medibrick2025/ECG_BIOZ_Brick/README.md

# Bio Impedance and Bio Potential

<a href="./assets/pictures/ECG_BIOZ_Front_Closed_without_Plugins.jpg" target="_blank" style="float: right; margin-left: 20px;">
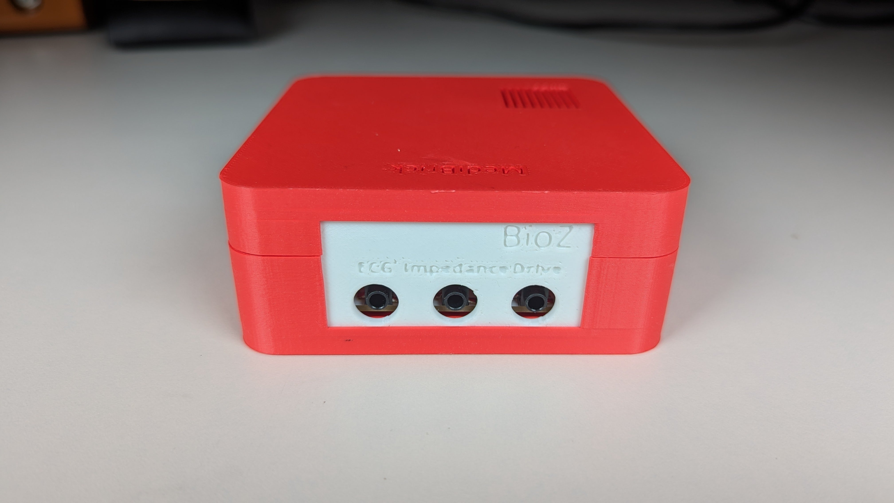
[picture p1: assets/pictures/ECG_BIOZ_Front_Closed_without_Plugins.jpg]
  
</a>

In the BIOZ and ECG MediBrick we use the MAXIM [MAX30001G](datasheets/max30001g.pdf) analog front end (AFE). It's a modern IC with a "waver level packaging" foot print which makes is difficult to solder and requires precise PCB manufacturing.

The MAX30001G can measure:

- Biopotential
  - ECG (waveform)
  - R-R Time (heart rate and heart rate variability)
- Bioimpedance
  - Resp (respiration rate)
  - GSR (galvanic skin response, stress level)
  - EDA (electro dermal activity)

In [MAX3001G](./docs/chips/MAX30001/MAX30001G.md) we summary capabilities from the datasheet.

For general consideration of bio impedance design and safety: [Analog Devices: Bio-Impedance Circuit Design for Body Worn Systems"](https://www.analog.com/en/resources/analog-dialogue/articles/bioimpedance-circuit-design-challenges.html)

## Costs &#36;

| Item | Quantity at Purchase | Costs  | Source | Cost per Brick
|--- | ---  | --- | --- | ---
| Microcontroller |  1 | $17.5  | [Adafruit](https://www.adafruit.com/product/5477) | $17.5
| Display |  5 | $13 | [Amazon](https://a.co/d/1QH0Ab9) | $3
| Button | 25 | $9 | [Amazon](https://a.co/d/8KAuTwC) | $0.5 
| Battery |  1 | $10 | [Adafruit](https://www.adafruit.com/product/258) | $10
| PCB |  5 | $145.80 | PCBWay | $29
| Parts and Assembly |  5 | $186.42 | PCBWay | $38
| Assorted Wires |8m | $15 | [Amazon](https://a.co/d/58djefc) | $1
| Assorted Screws and Nuts |100 |  $7 | Amazon | $0.05
| Assorted 3D printed parts | | | | $3
| ECG 3.5mm cables | 1  | $5.50 | [Sparkfun](https://www.sparkfun.com/products/12970) | $5.50
| Electrodes (consumable) | 100 | $25 | [Amazon](https://a.co/d/85M2rC2) | $ 1
| | | | |
| **Total** | | | | **$110**

Electronic components are $20 per board. Because of WLP foot print of MAX30001G the PCB is 3 times as expensive as the other PCBs.

## Test Software &#128187;
Test software is located in the Arduino folder.

| Folder | Description | 
|--- |---|
| MAX30001G Driver | under development |
| Test programs | not available yet |

## Microcontroller Software : &#9000;
Not available yet.

## Electronics Design &#128268;

<a href="./hardware/schemaric/Impedance_Potential_schematic.pdf" target="_blank">
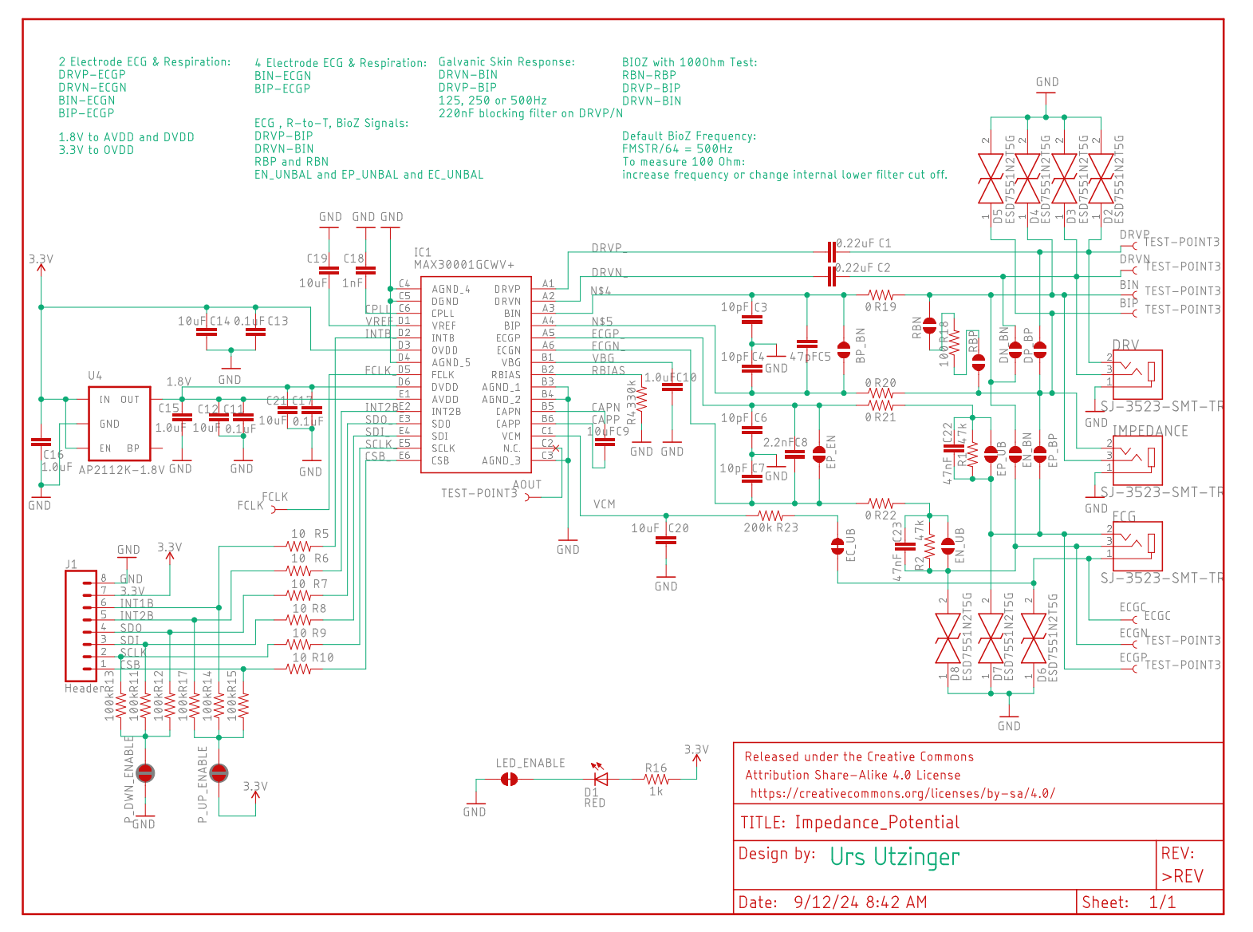
[picture p2: hardware/schemaric/Impedance_Potential_schematic.png]
  
</a>

<a href="./hardware/layout/Impedance_Potential_board.pdf" target="_blank">
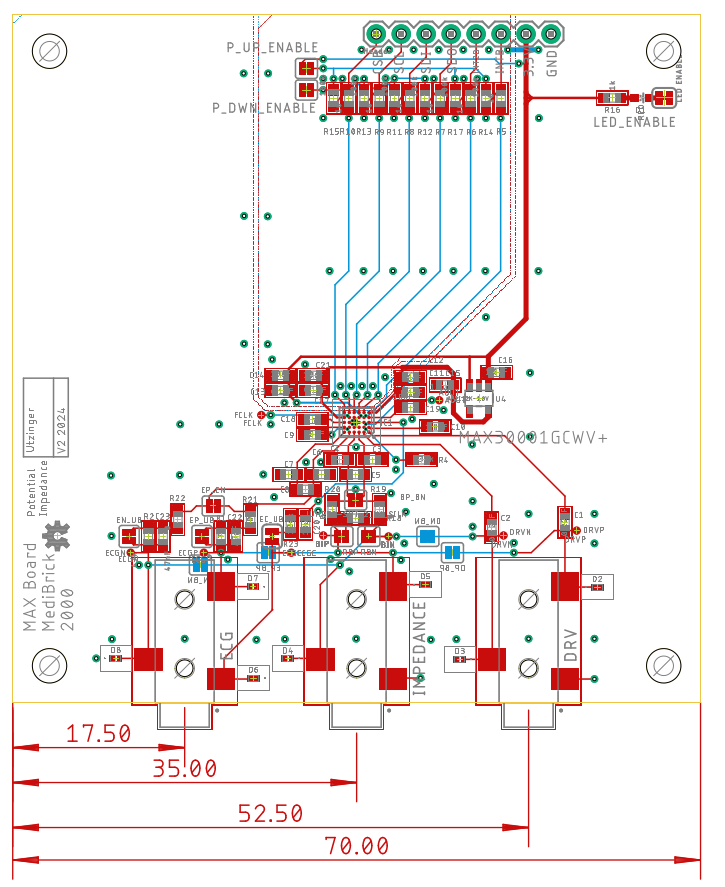
[picture p3: hardware/layout/Impedance_Potential_board.png]
  
</a>

The following files are needed for PCB manufacturing and assembly.

- [Bill of Materials](./hardware/bom/Impedance_Potential_BOM.xlsx)
- [Manufacturing Files](./hardware/manufacturing/Impedance_Potential_2024-09-12.zip)
- [Pick and Place](./hardware/pick_and_place/Impedance_Potential_PnP.xlsx)

The Bill of Materials is formatted so that its compatible with PCBWay submissions.

## 3D Printed Parts &#9881;
These are the links to the OnShape Design files, which you can edit and modify if you have an OnShape account (OnShape has free academic accounts).

- Medi Brick
  - [Brick Top](https://cad.onshape.com/documents/be6b7e5f847d89f3ec5eb9d5/w/761fee9865ca7ef709028476/e/ff897b4f359cec83b782ff14)
  - [Brick Bottom](https://cad.onshape.com/documents/92ad78475e8f0b17ff5e260b/w/88a02abbcb12cdbd4d9de3ad/e/fb79ca58ad2b6a0298e9d1b6)
  - [Brick Assembly](https://cad.onshape.com/documents/11cbfe9c3c739b6e8ecbf3d7/w/989b564ecd7f6d069e643ac0/e/85542f706be8cc7554218e8d)
  - [Impedance Potential Plate](https://cad.onshape.com/documents/4b23bdc1fe41aa5490b46d9c/w/fd4737f6a1ca7fbcd3b1d7f7/e/89122d5ddac798ebf451ad60)

## Assembly Instructions &#128736;
[Instructions](./docs/assembly.md)

## MAX30001G Design

## Block Diagram of MAX 30001G

<a href="./assets/Blockdiagram.png" target="_blank">
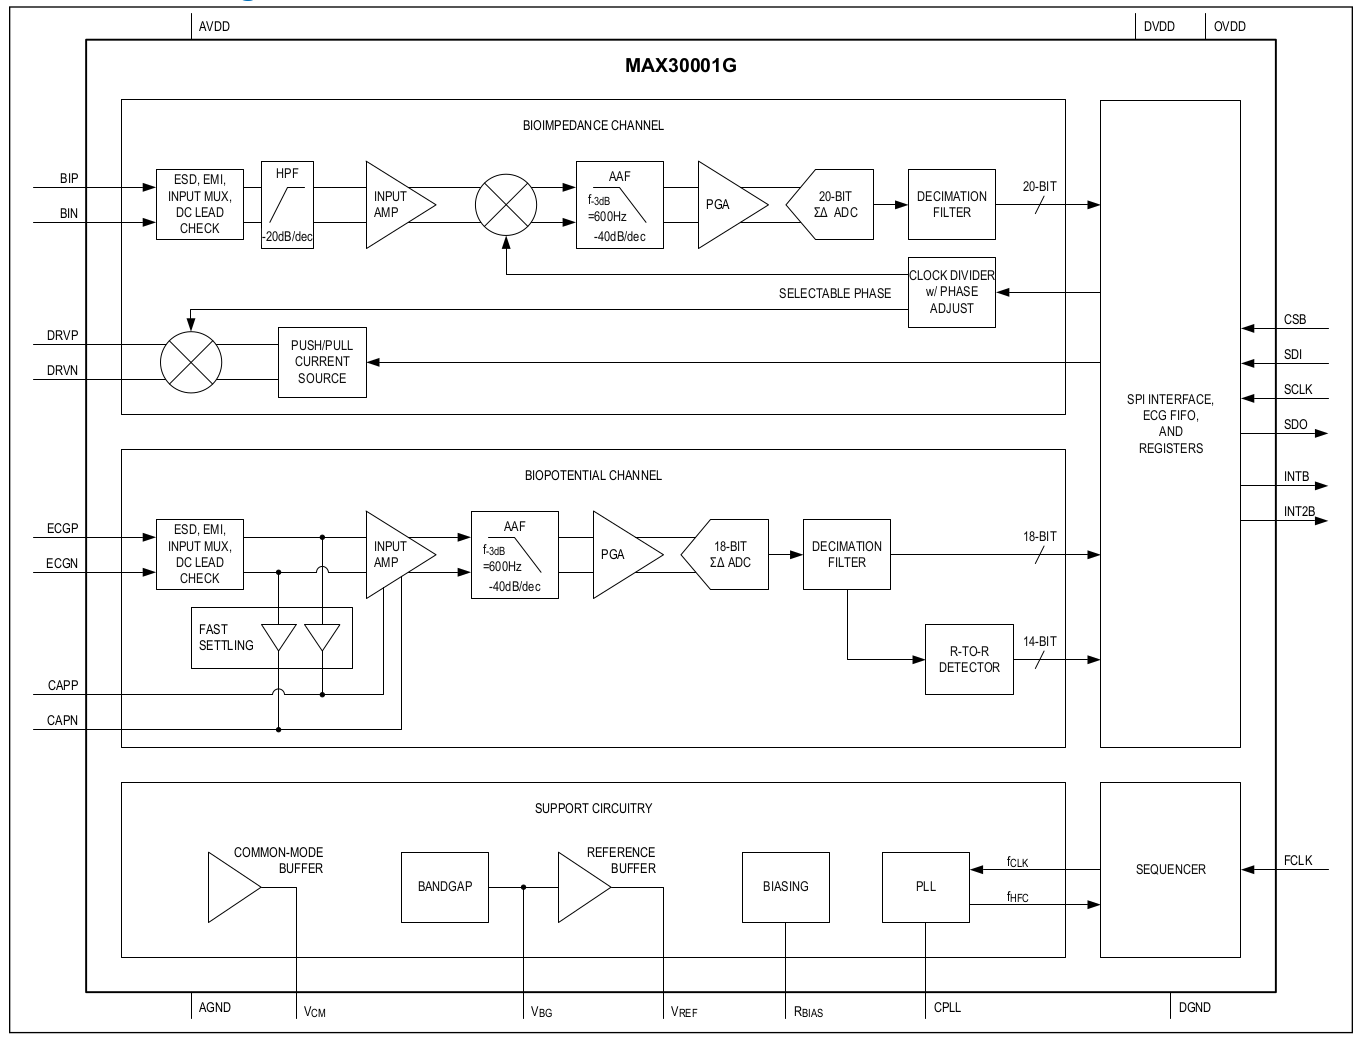
[picture p4: assets/Blockdiagram.png]
  
</a>

## External Configuration Options

<a href="./docs/images/system/Design.svg" target="_blank">
  
</a>

We have the following external connectors:
- ECG, 3,5mm audio
    - ECG_N (middle of plug) e.g. left arm
    - ECG_P (proximal side of plug) e.g. right arm
    - VCM/ECG_GND (common mode) (tip of plug) e.g. leg

- Impedance, 3.5mm audio
    - BI_N
    - BI_P
    - GND (tip of plug)

- Driver, 3.5mm audio
    - DRV_P
    - DRV_N
    - GND (tip of plug)

### Options
- We can operate the board to measure ECG or Impedance or both. 
- We can operate the board to use only two leads, four leads or six leads. 
    - 6 leads ECG on ECGP & ECGN, BIOZ on BINP & BINN and DRV on DRVP & DRVN
    - 4 leads ECG on ECGP & ECGN, BIOZ on BINP & BINN
    - 2 leads ECG, BIOZ, DRV on ECGP & ECGN
- We can configure the board to measure impedance of a calibration resistor that is soldered onto the board (100 Ohm).

### Component Values

Typical values and conditions of external components

Name      | typical value | Comment
----------|---------------|--------
C_ECG     | 2.2nF         | datasheet
C_ECG-G   | 10pF          | datasheet, 47pF protocentral
EP_EN     | open          | if closed disable ECG
R_ECG     | 0,51k,200k Ohm | 0, 200k shown in datasheet (200k when ECG conencted with BIOZ), 51k protocentral, 0 Ohm evaluation kit
R_ECG-B   | 51k           | evaluation kit
C_ECG_B   | 47nF          | evaluation kit
ECG_UNBAL | open          | if closed disable balancing
||
EP_BP     | open          | impedance and ECG is on different plug
EN_BN     | open          | impedance and ECG is on different plug
||
C_BIN     | 47pF          | datasheet
C_BIN_G   | 10pF          | datasheet
BP_BN     | open          | if closed disable BioZ
R_BIN     | 0, 200 Ohm    | 200 protocentral where ECG is connected to BIN, 0 evaluation kit
R_CAL     | 100 Ohm       | evaluation kit
RP        | open          | if closed no external impedance
RN        | open          | "
||
BP_DP     | open          | impedance and driver on different plug
BN_DN     | open          | impedance and driver on different plug
||
C_DRV     | 200nF, 47nF   | 47nF protocentral, 47nF evaluation kit
||
R_VCM     | 0 Ohm,10k,200k| 10k protocentral, evaluation kit has buffer driver circuit, 200k datasheet
R_VCM-B   | 51k, none     | none protocentral & evaluation kit
C_VCM-B   | 47nF, none    | none protocentral & evaluation kit, 47nF datasheet
VMC_UNBAL | open          | 

## Education Background

This section provides the theoretical and physiological background related to ECG and bioimpedance measurements

- [ECG Education Background](./docs/ECG_Education_Background/README.md)
