medibrick2025/ECG_BIOZ_Brick/assets/BIOZ_Channel.png

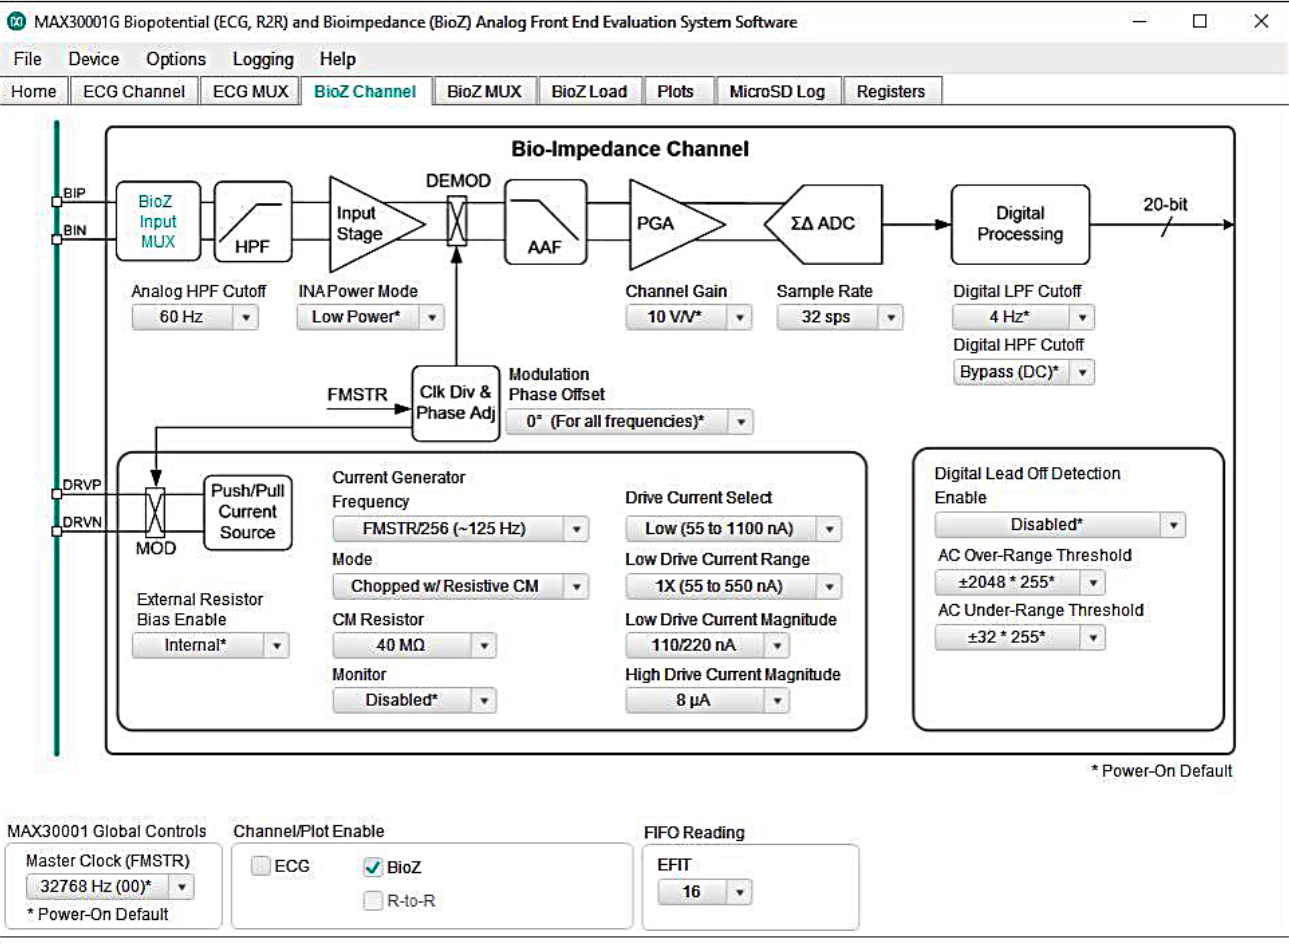
assets/BIOZ_Channel.png
