medibrick2025/ECG_BIOZ_Brick/assets/BIOZ_Load.png

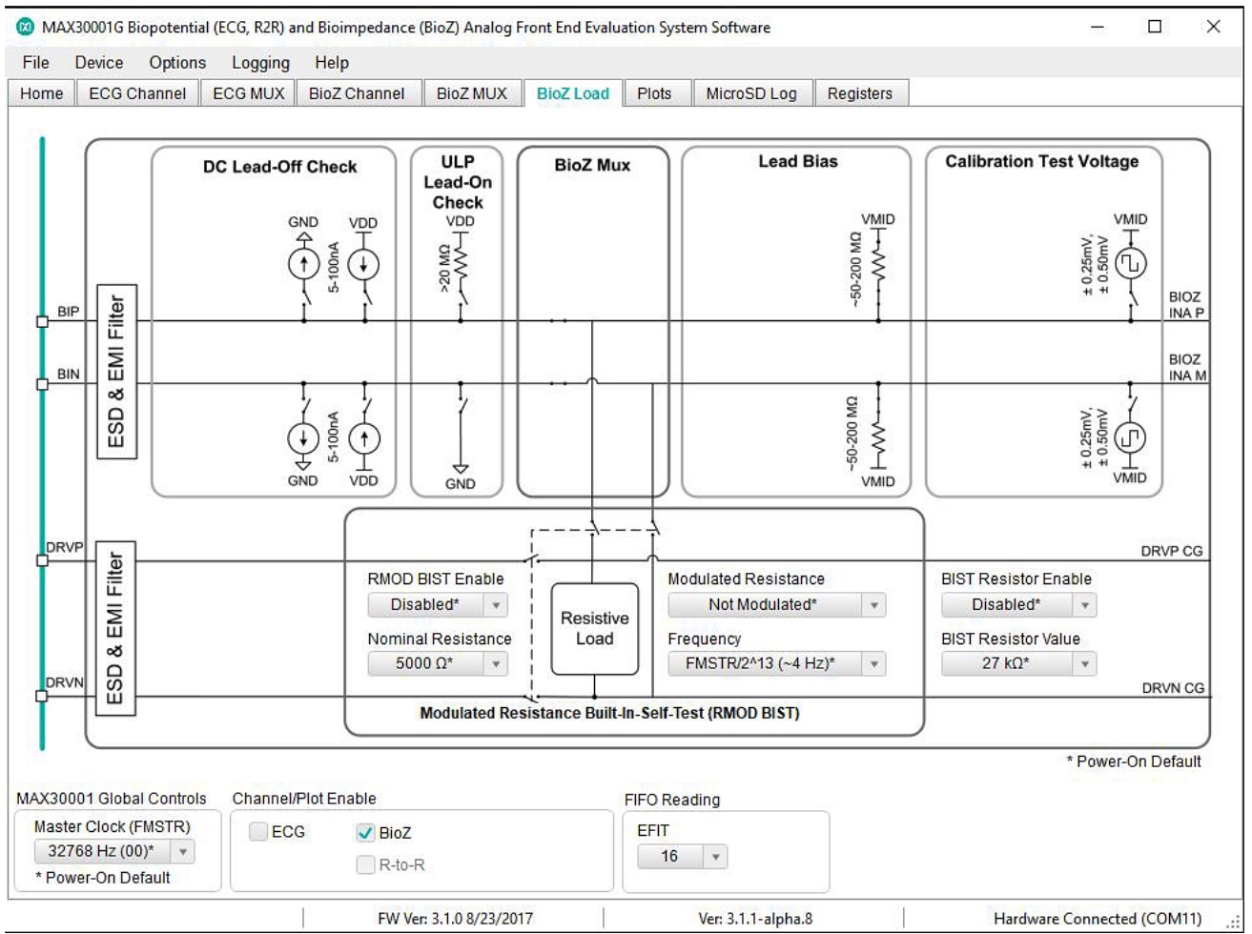
assets/BIOZ_Load.png
