medibrick2025/ECG_BIOZ_Brick/assets/BIOZ_MUX.png

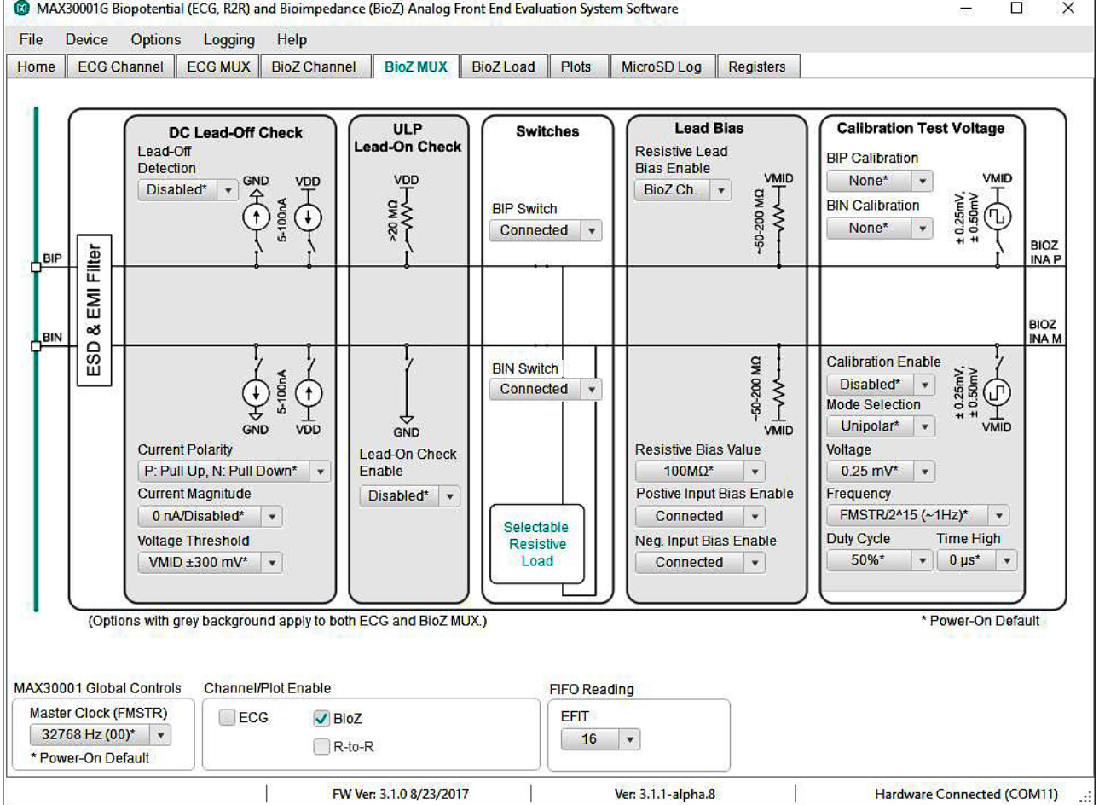
assets/BIOZ_MUX.png
