medibrick2025/ECG_BIOZ_Brick/assets/ECG_Channel.png

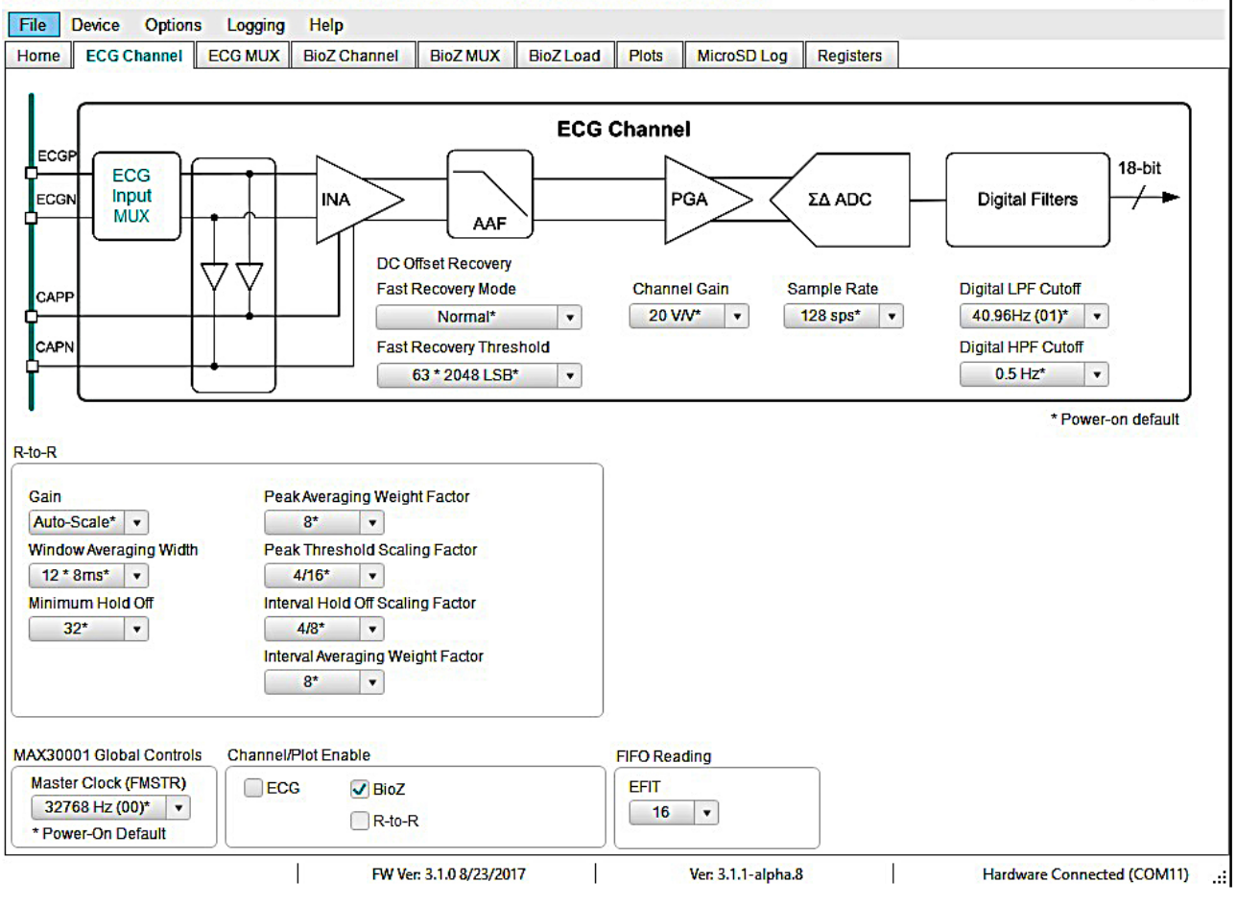
assets/ECG_Channel.png
