medibrick2025/ECG_BIOZ_Brick/assets/ECG_Mux.png

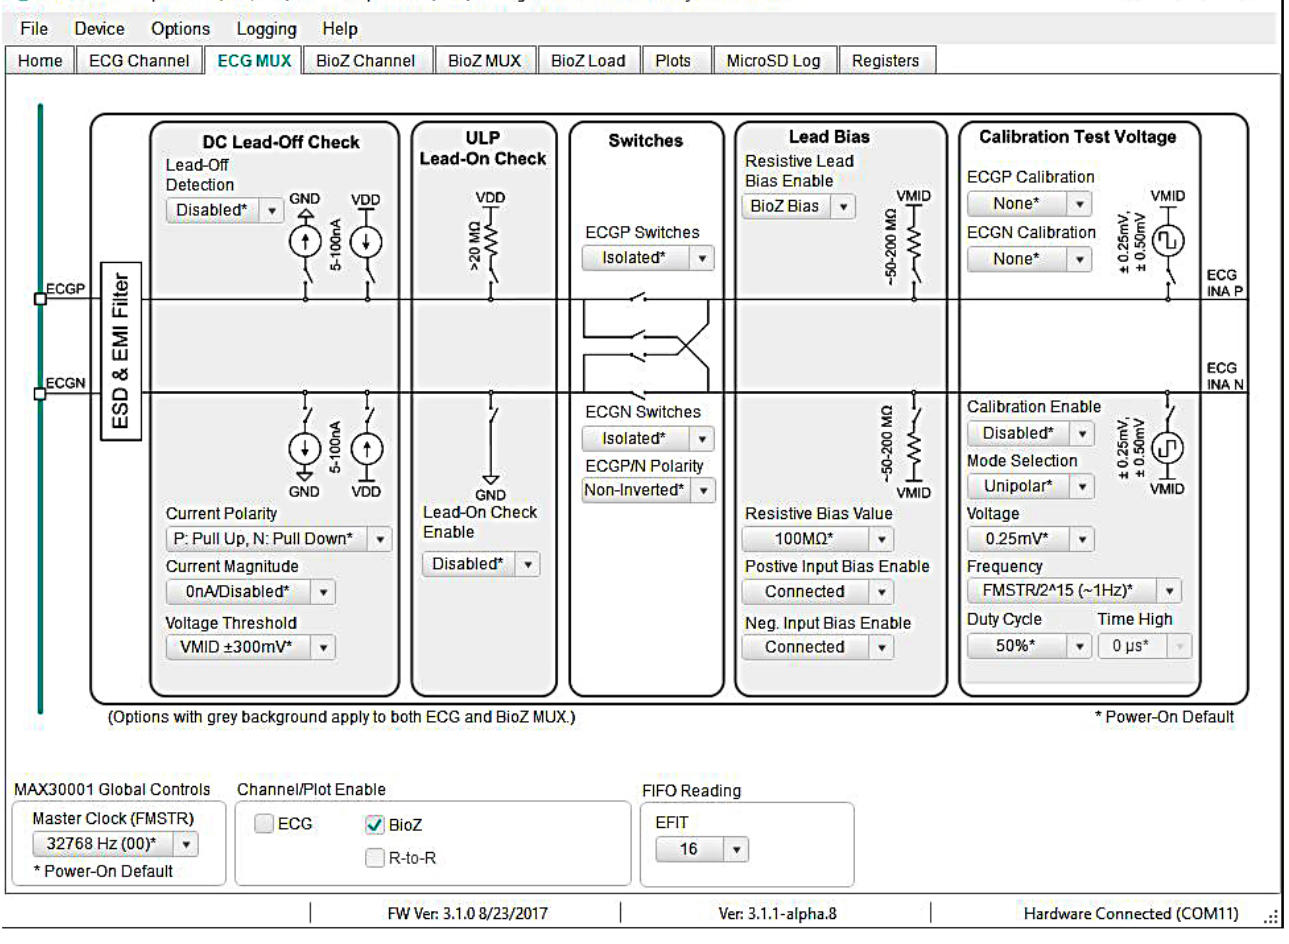
assets/ECG_Mux.png
