medibrick2025/ECG_BIOZ_Brick/assets/ECG_Plots.png

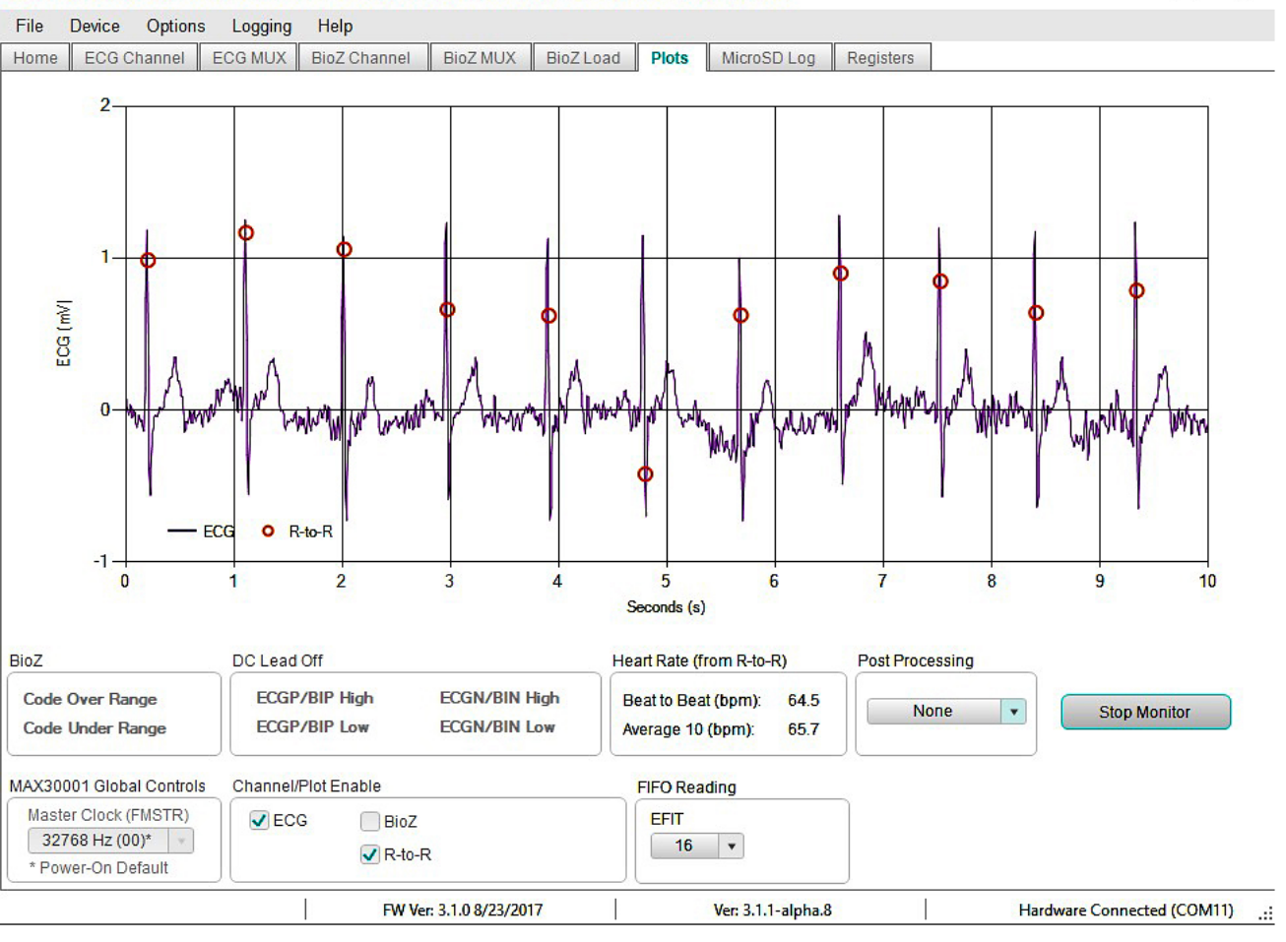
assets/ECG_Plots.png
