medibrick2025/ECG_BIOZ_Brick/pcbway/T-1Y6W735621A-5sets-Impedance_Potential_BOM_No3p5Audio(2024-04-29).xls

PCBWay Bom Quotation, Product No.:T-1Y6W735621A
Item # | *Designator | *Qty | Manufacturer | *Mfg Part # | Description / Value | Vendor Part # | *Package/Footprint | Mounting Type | *Unit Price(5 sets) | *Total | *Delivery Time | *PCBWay Note | Customer Reply
1 | C1, C2 | 2 | Samsung Electro-Mechanics | CL10B224KA8NNNC | 0.22uF Ceramic Capacitor >=25V | C21120 | 603 | SMD | $0.050 | $0.500
2 | C3, C4, C6, C7 | 4 | Samsung Electro-Mechanics | CL10C100JB8NNNC | 10pF Ceramic Capacitor >=25V | C1634 | 603 | SMD | $0.037 | $0.740
3 | C5 | 1 | Samsung Electro-Mechanics | CL10C470JB8NNNC | 47pF Ceramic Capacitor >=25V | C1671 | 603 | SMD | $0.050 | $0.250
4 | C8 | 1 | Samsung Electro-Mechanics | CL10B222KB8NNNC | 2.2nF Ceramic Capacitor >=25V | C16033 | 603 | SMD | $0.050 | $0.250
5 | C9, C12, C14, C19, C20, C21 | 6 | Samsung Electro-Mechanics | CL10A106MA8NRNC | 10uF Ceramic Capacitor >=25V | C96446 | 603 | SMD | $0.034 | $1.020
6 | C10, C15, C16 | 3 | Samsung Electro-Mechanics | CL10A105KB8NNNC | 1.0uF Ceramic | C15849 | 603 | SMD | $0.040 | $0.600
7 | C11, C13, C17 | 3 | Samsung Electro-Mechanics | CL10B104KB8NNNC | 0.1uF Ceramic Capacitor >=25V | C1591 | 603 | SMD | $0.022 | $0.330
8 | C18 | 1 | Samsung Electro-Mechanics | CL10B102KB8NNNC | 1nF Ceramic Capacitor >= 25V | C1588 | 603 | SMD | $0.050 | $0.250
9 | C22, C23, C24 | 3 | Samsung Electro-Mechanics | CL10B473KB8NNNC | 47nF Ceramic Capacitor >=25V | C1622 | 603 | SMD | $0.039 | $0.585
10 | R1, R2, R3 | 3 | YAGEO | RC0603FR-0751KL | 51k 100mW Resistor | C107231 | 603 | SMD | $0.011 | $0.165
11 | R4 | 1 | YAGEO | RT0603BRE07324KL | 324k 100mW Resistor | C861836 | 603 | SMD | $0.147 | $0.735
12 | R5, R6, R7, R8, R9, R10 | 6 | YAGEO | RC0603JR-0710RL | 10 100mW Resistor | C109317 | 603 | SMD | $0.009 | $0.270
13 | R11, R12, R13, R14, R15, R17 | 6 | YAGEO | RC0603FR-07100KL | 100k 100mW Resistor | C14675 | 603 | SMD | $0.004 | $0.120
14 | R16 | 1 | YAGEO | RC0603FR-071KL | 1k 100mW Resistor | C22548 | 603 | SMD | $0.026 | $0.130
15 | R18 | 1 | YAGEO | RC0603JR-07100RL | 100 100mW Resistor | C110091 | 603 | SMD | $0.029 | $0.145
16 | R19, R20, R21, R22, R23 | 5 | YAGEO | RC0603JR-070RL | 0 100mW Resistor | C95177 | 603 | SMD | $0.005 | $0.125
17 | D2, D3, D4, D5, D6, D7, D8 | 7 | onsemi | ESD7551N2T5G | ESD7551N2T5G, Protection Diode | C5123457『 』https://www.mouser.com/ProductDetail/onsemi/ESD7551N2T5G?qs=5aG0NVq1C4x8NutXGbtG6w%3D%3D | ESD7551N2T5G | SMD | $0.308 | $10.780
18 | D1 | 1 | XINGLIGHT | XL-1608UBC-04 | Blue LED | C965807 | 603 | SMD | $0.095 | $0.475
19 | IC1 | 1 | Analog Devices/Maxim | MAX30001GCWV+ | MAX30001GCWV+ | https://www.mouser.com/ProductDetail/Analog-Devices-Maxim-Integrated/MAX30001GCWV%2b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 | BGA30C50P6X5_293X274X69 | SMD | $15.776 | $78.880 | 7-10 Workdays | Only 200pcs total in stock, please confirm ASAP.
20 | U4 | 1 | Diodes Incorporated | AP2112K-1.8TRG1 | AP2112K-1.8V V_REG_LDO SMD | C176944『 』https://www.mouser.com/ProductDetail/Diodes-Incorporated/AP2112K-1.8TRG1?qs=x6A8l6qLYDBx1xhw8AX2cw%3D%3D | SOT-25 | SMD | $0.413 | $2.065
 |  |  |  |  |  |  |  |  | Component Cost | $98.41
