medibrick2025/ECG_BIOZ_Brick/hardware/layout/Impedance_Potential.brd

## EAGLE design hardware/layout/Impedance_Potential.brd (2025-12-08)

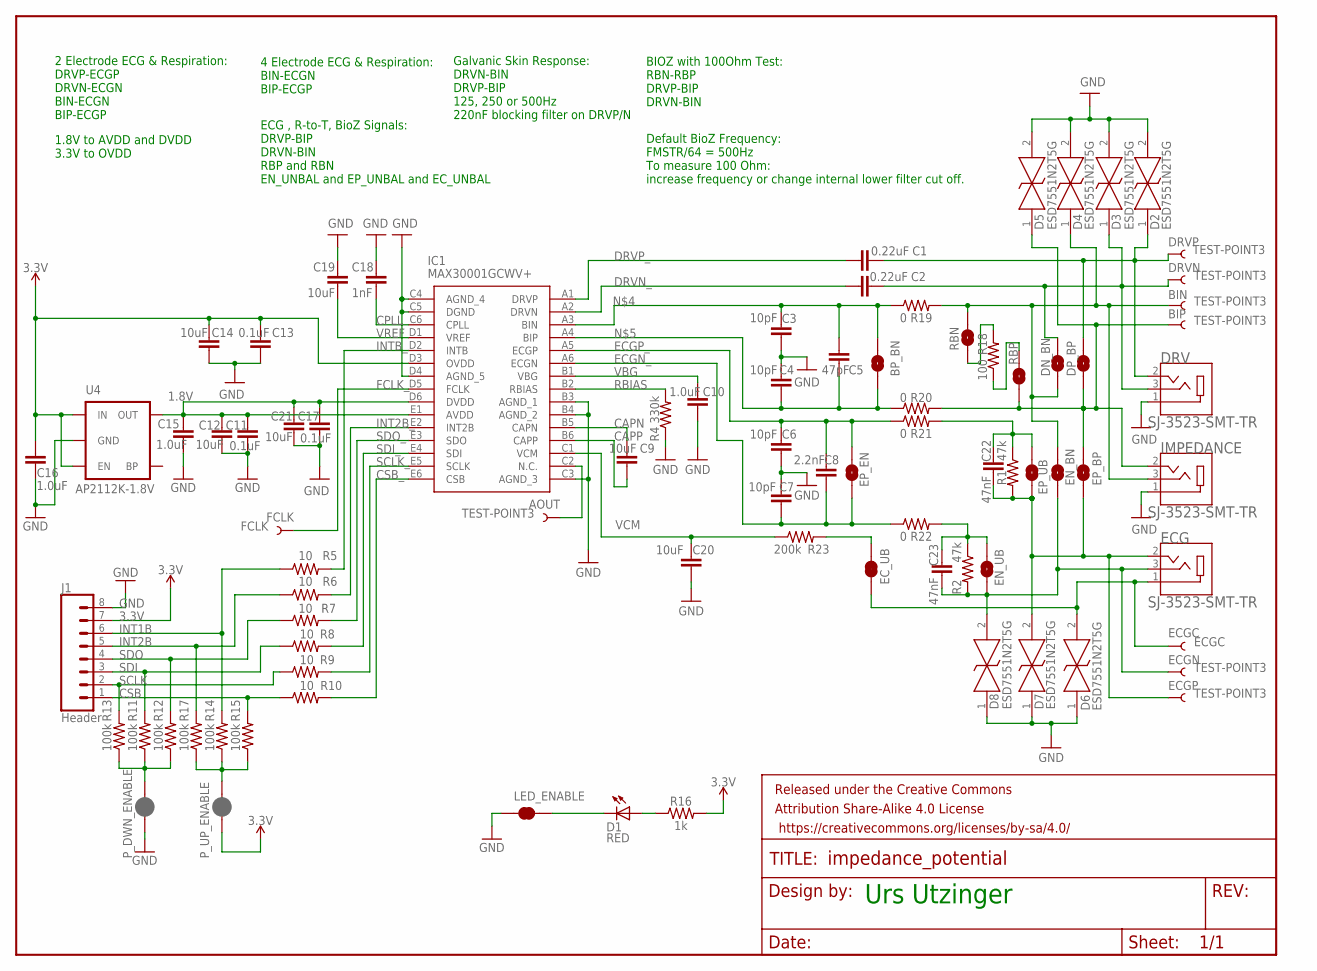
[picture p39: schematic Impedance_Potential.sch]

Parts:
AOUT: TEST-POINT3; PAD.03X.03
BIN: TEST-POINT3; PAD.03X.03
BIP: TEST-POINT3; PAD.03X.03
BP_BN: JUMPER-SMT_2_NO_SILK; SMT-JUMPER_2_NO_SILK
C1, C2: 0.22uF; 0603
C3, C4, C6, C7: 10pF; 0603
C5: 47pF; 0603
C8: 2.2nF; 0603
C9, C12, C14, C19, C20, C21: 10uF; 0603
C10, C15, C16: 1.0uF; 0603
C11, C13, C17: 0.1uF; 0603
C18: 1nF; 0603
C22, C23: 47nF; 0603
D1: RED; LED-0603
D2, D3, D4, D5, D6, D7, D8: ESD7551N2T5G
DN_BN: JUMPER-SMT_2_NO_SILK; SMT-JUMPER_2_NO_SILK
DP_BP: JUMPER-SMT_2_NO_SILK; SMT-JUMPER_2_NO_SILK
DRV: SJ-3523-SMT-TR; CUI_SJ-3523-SMT-TR
DRVN: TEST-POINT3; PAD.03X.03
DRVP: TEST-POINT3; PAD.03X.03
ECG: SJ-3523-SMT-TR; CUI_SJ-3523-SMT-TR
ECGC: ECGC; PAD.03X.03
ECGN: TEST-POINT3; PAD.03X.03
ECGP: TEST-POINT3; PAD.03X.03
EC_UB: JUMPER-SMT_2_NC_TRACE_SILK; SMT-JUMPER_2_NC_TRACE_SILK
EN_BN: JUMPER-SMT_2_NO_SILK; SMT-JUMPER_2_NO_SILK
EN_UB: JUMPER-SMT_2_NO_SILK; SMT-JUMPER_2_NO_SILK
EP_BP: JUMPER-SMT_2_NO_SILK; SMT-JUMPER_2_NO_SILK
EP_EN: JUMPER-SMT_2_NO_SILK; SMT-JUMPER_2_NO_SILK
EP_UB: JUMPER-SMT_2_NO_SILK; SMT-JUMPER_2_NO_SILK
FCLK: FCLK; PAD.03X.03
FRAME1: FRAME-LETTERNO_PACKAGE; DUMMY
IC1: MAX30001GCWV+; BGA30C50P6X5_293X274X69
IMPEDANCE: SJ-3523-SMT-TR; CUI_SJ-3523-SMT-TR
J1: Header; 1X08
LED_ENABLE: LED ENABLE; SMT-JUMPER_2_NC_TRACE_SILK
P_DWN_ENABLE: JUMPER-SMT_2_NC_PASTE_SILK; SMT-JUMPER_2_NC_PASTE_SILK
P_UP_ENABLE: JUMPER-SMT_2_NC_PASTE_SILK; SMT-JUMPER_2_NC_PASTE_SILK
R1, R2: 47k; 0603
R4: 330k; 0603
R5, R6, R7, R8, R9, R10: 10; 0603
R11, R12, R13, R14, R15, R17: 100k; 0603
R16: 1k; 0603
R18: 100; 0603
R19, R20, R21, R22: 0; 0603
R23: 200k; 0603
RBN: JUMPER-SMT_2_NO_SILK; SMT-JUMPER_2_NO_SILK
RBP: JUMPER-SMT_2_NO_SILK; SMT-JUMPER_2_NO_SILK
U4: AP2112K-1.8V; SPARKFUN-POWERIC_SOT23-5

Connections:
1.8V: C11.1, C12.1, C15.2, C17.1, C21.1, IC1.D6 (DVDD), IC1.E1 (AVDD), U4.5 (OUT)
3.3V: C13.1, C14.1, C16.2, IC1.D3 (OVDD), J1.7, P_UP_ENABLE.1, R16.2, U4.1 (IN), U4.3 (EN)
AOUT: AOUT.P$1, IC1.C2 (N.C.)
BIN: BIN.P$1, D4.1, DN_BN.1, EN_BN.2, IMPEDANCE.3, R19.2, RBN.2
BIP: BIP.P$1, D5.1, DP_BP.1, EP_BP.2, IMPEDANCE.2, R20.2, RBP.1
CAPN: C9.1, IC1.B5 (CAPN)
CAPP: C9.2, IC1.B6 (CAPP)
CPLL: C18.2, IC1.C6 (CPLL)
CSB: J1.1, R10.1, R15.2
CSB_: IC1.E6 (CSB), R10.2
DRVN: C2.2, D3.1, DN_BN.2, DRV.3, DRVN.P$1
DRVN_: C2.1, IC1.A2 (DRVN)
DRVP: C1.2, D2.1, DP_BP.2, DRV.2, DRVP.P$1
DRVP_: C1.1, IC1.A1 (DRVP)
ECGC: D6.2, ECG.1, ECGC.P$1, EC_UB.1
ECGN: C23.2, D8.2, ECG.3, ECGN.P$1, EN_BN.1, EN_UB.1, R2.2
ECGN_: C7.2, C8.2, EP_EN.1, IC1.A6 (ECGN), R22.1
ECGP: C22.2, D7.2, ECG.2, ECGP.P$1, EP_BP.1, EP_UB.1, R1.2
ECGP_: C6.1, C8.1, EP_EN.2, IC1.A5 (ECGP), R21.1
FCLK_: FCLK.P$1, IC1.D5 (FCLK)
GND: C3.2, C4.1, C6.2, C7.1, C10.2, C11.2, C12.2, C13.2, C14.2, C15.1, C16.1, C17.2, C18.1, C19.1, C20.2, C21.2, D2.2, D3.2, D4.2, D5.2, D6.1, D7.1, D8.1, DRV.1, IC1.B3 (AGND_1), IC1.B4 (AGND_2), IC1.C3 (AGND_3), IC1.C4 (AGND_4), IC1.C5 (DGND), IC1.D4 (AGND_5), IMPEDANCE.1, J1.8, LED_ENABLE.1, P_DWN_ENABLE.1, R4.1, U4.2 (GND)
INT1B: J1.6, R5.1, R14.2
INT2B: J1.5, R6.1, R17.2
INT2B_: IC1.E2 (INT2B), R6.2
INTB_: IC1.D2 (INTB), R5.2
unnamed: C23.1, EN_UB.2, R2.1, R22.2
unnamed: EC_UB.2, R23.2
unnamed: C22.1, EP_UB.2, R1.1, R21.2
unnamed: BP_BN.2, C3.1, C5.1, IC1.A3 (BIN), R19.1
unnamed: BP_BN.1, C4.2, C5.2, IC1.A4 (BIP), R20.1
unnamed: D1.A, R16.1
unnamed: D1.C, LED_ENABLE.2
unnamed: P_DWN_ENABLE.2, R11.1, R12.1, R13.1
unnamed: P_UP_ENABLE.2, R14.1, R15.1, R17.1
unnamed: R18.2, RBN.1
unnamed: R18.1, RBP.2
RBIAS: IC1.B2 (RBIAS), R4.2
SCLK: J1.2, R9.1, R13.2
SCLK_: IC1.E5 (SCLK), R9.2
SDI: J1.3, R8.1, R11.2
SDI_: IC1.E4 (SDI), R8.2
SDO: J1.4, R7.1, R12.2
SDO_: IC1.E3 (SDO), R7.2
VBG: C10.1, IC1.B1 (VBG)
VCM: C20.1, IC1.C1 (VCM), R23.1
VREF: C19.2, IC1.D1 (VREF)

Notes on the sheet:
2 Electrode ECG & Respiration: DRVP-ECGP DRVN-ECGN BIN-ECGN BIP-ECGP
4 Electrode ECG & Respiration: BIN-ECGN BIP-ECGP
Galvanic Skin Response: DRVN-BIN DRVP-BIP 125, 250 or 500Hz 220nF blocking filter on DRVP/N
BIOZ with 100Ohm Test: RBN-RBP DRVP-BIP DRVN-BIN
1.8V to AVDD and DVDD 3.3V to OVDD
ECG , R-to-T, BioZ Signals: DRVP-BIP DRVN-BIN RBP and RBN EN_UNBAL and EP_UNBAL and EC_UNBAL
Default BioZ Frequency: FMSTR/64 = 500Hz To measure 100 Ohm: increase frequency or change internal lower filter cut off.
Urs Utzinger

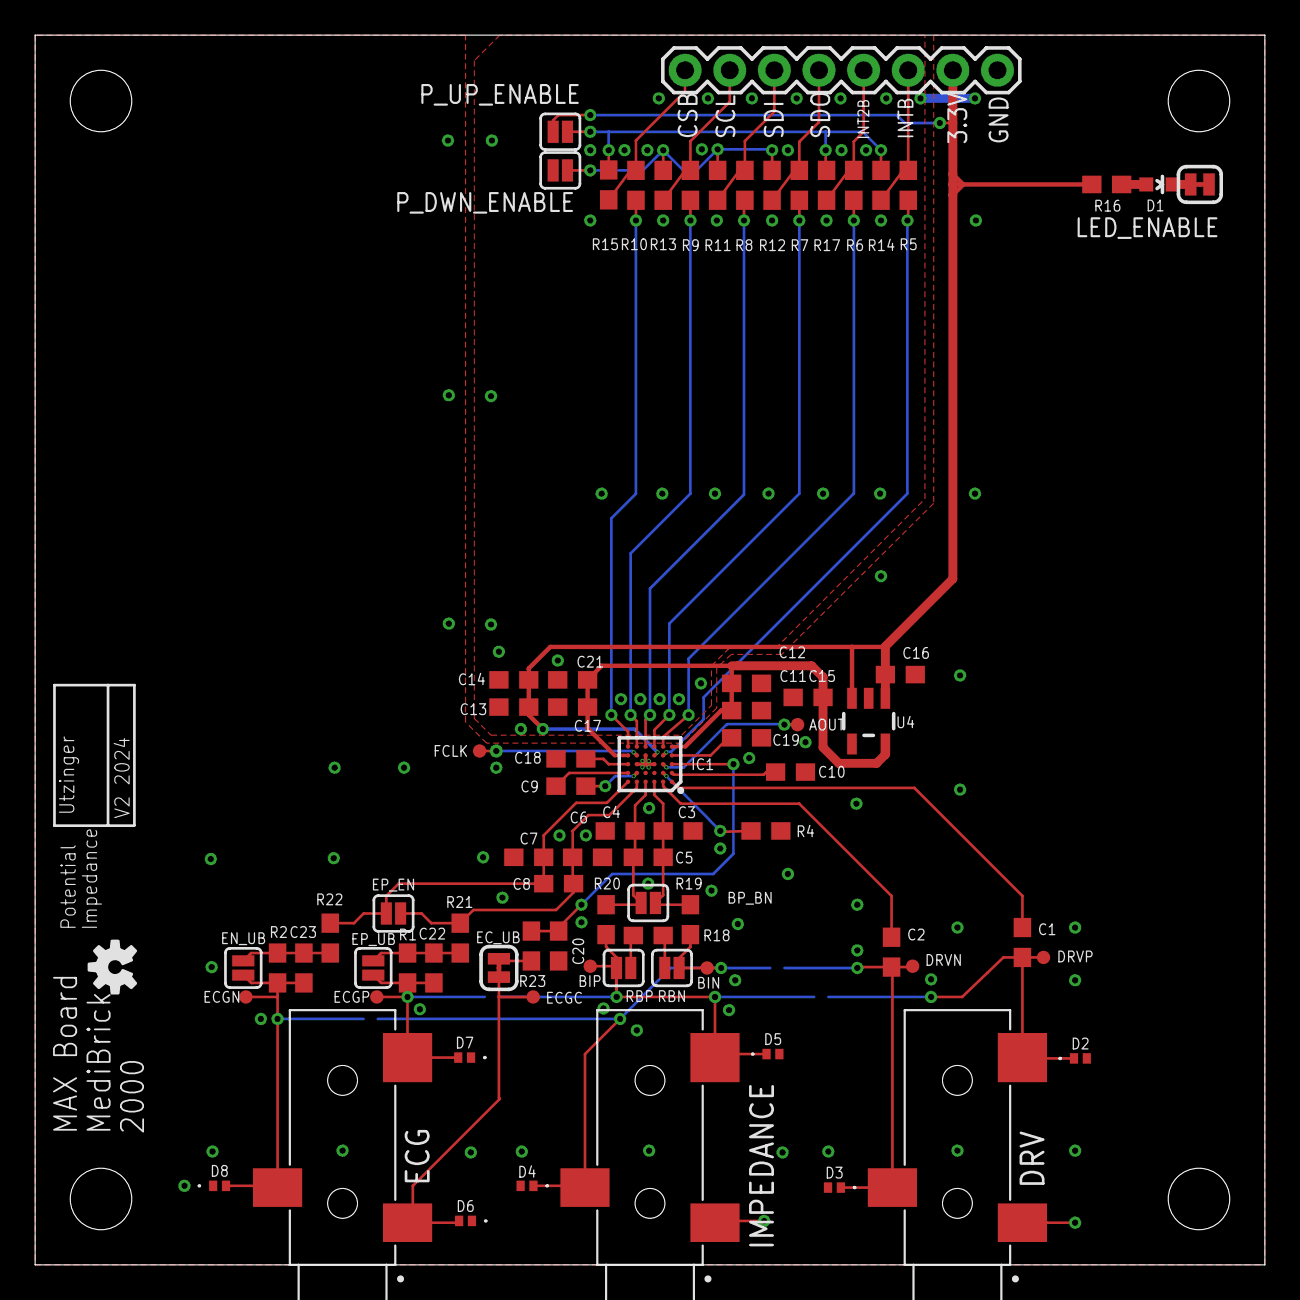
[picture p40: board Impedance_Potential.brd from above]

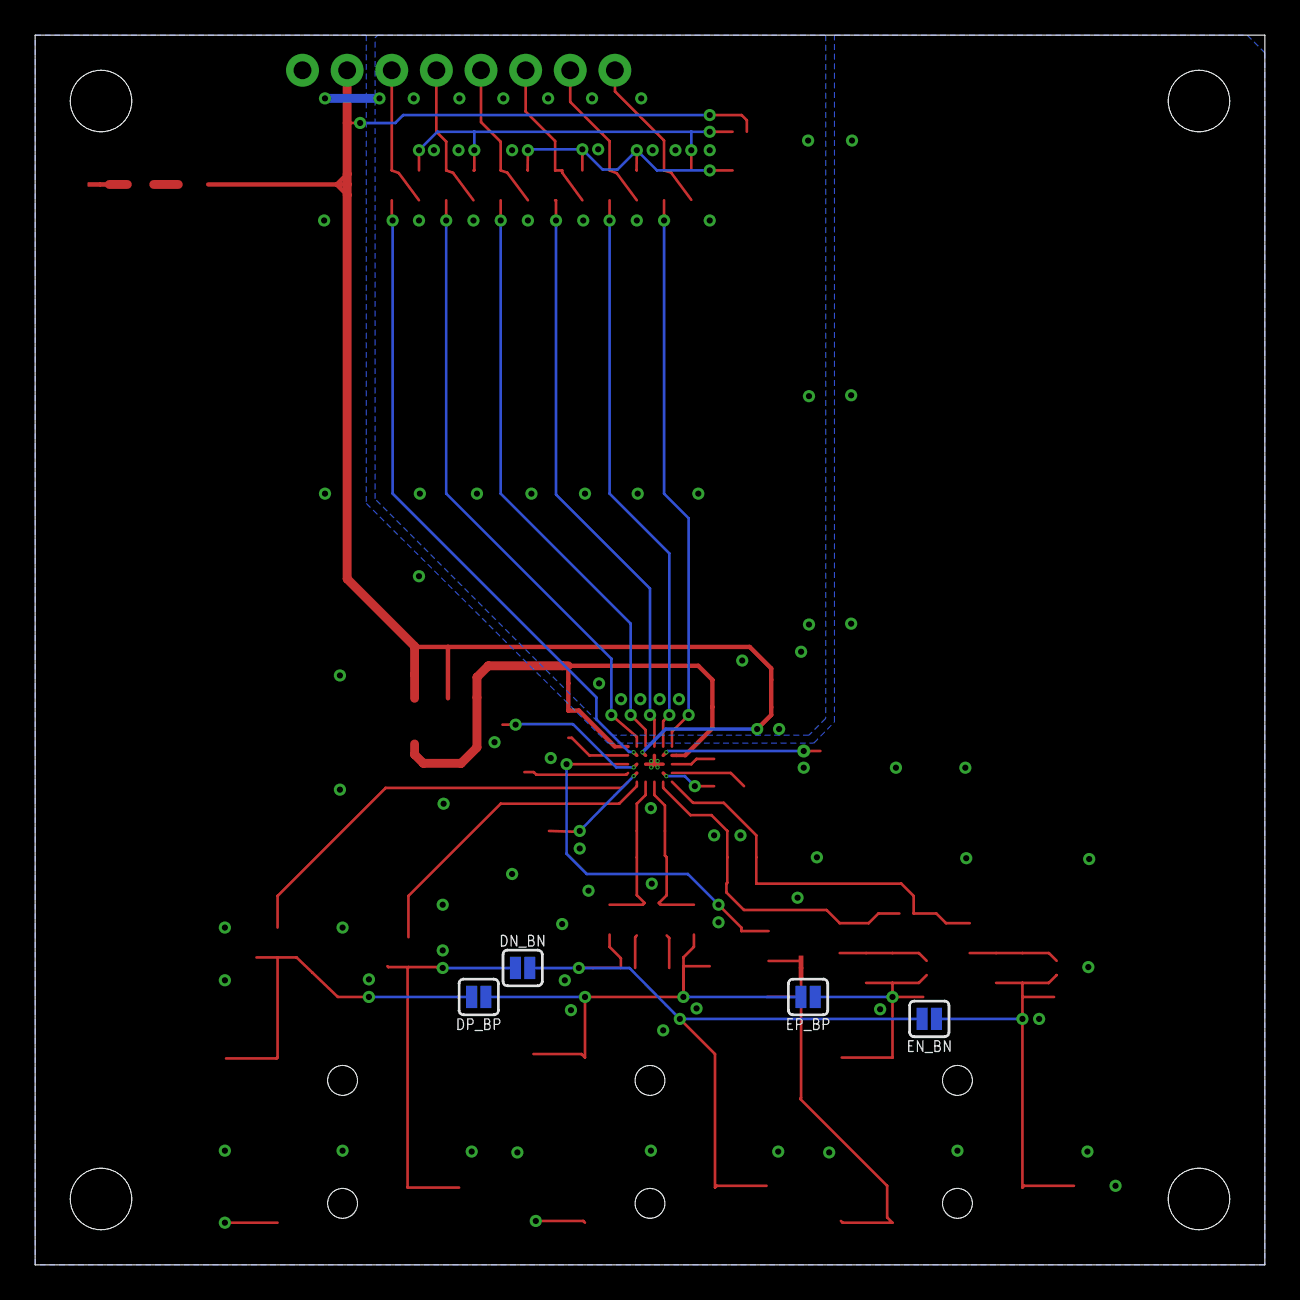
[picture p41: board Impedance_Potential.brd from below]

Board: 2 copper layers, 70.0 x 70.0 mm, 84 parts (4 on the bottom side), 46 nets.

Other parts of the board:
U$1: OSHW-LOGO-S
