medibrick2025/ECG_BIOZ_Brick/(commit log)

2026-02-02 Add ECG education background documentation and reorganize docs structure
    [Impedance_Potential.brd, Impedance_Potential.sch, Impedance_Potential_BOM.xlsx, Impedance_Potential_BOM_No3p5Audio.xlsx, Impedance_Potential_No3p5Audio_PnP.xlsx, Impedance_Potential_PnP.xlsx]
2026-02-02 Fix image paths in README and assembly docs
